luadeprataart/LED-to-LED-Communication/Documentacao/Validando_COMUNICACAO.jpeg

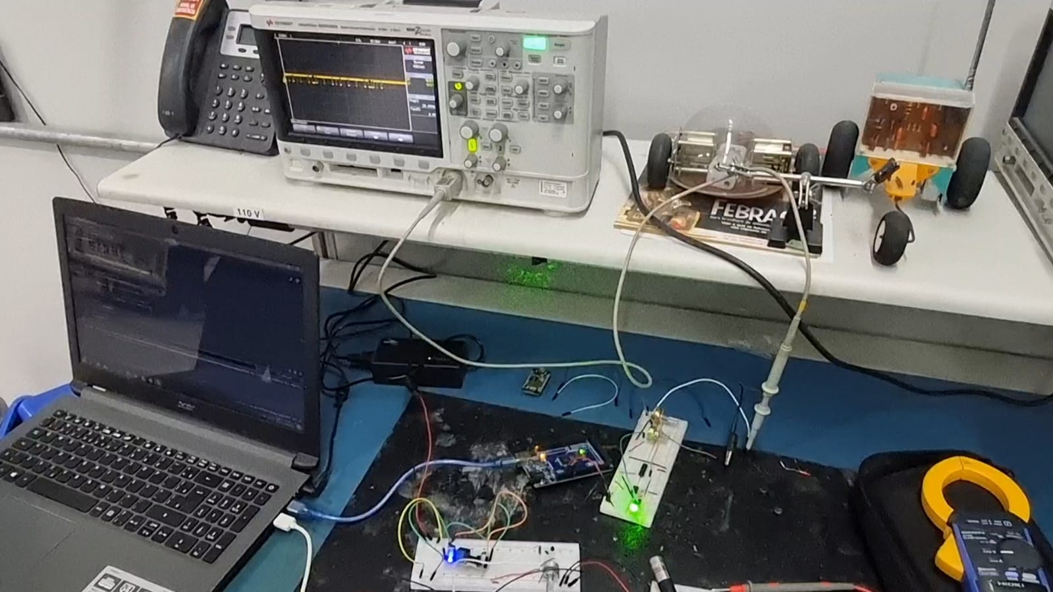
Documentacao/Validando_COMUNICACAO.jpeg
