luadeprataart/LED-to-LED-Communication/Documentacao/Validando_COMUNICACAO2.jpeg

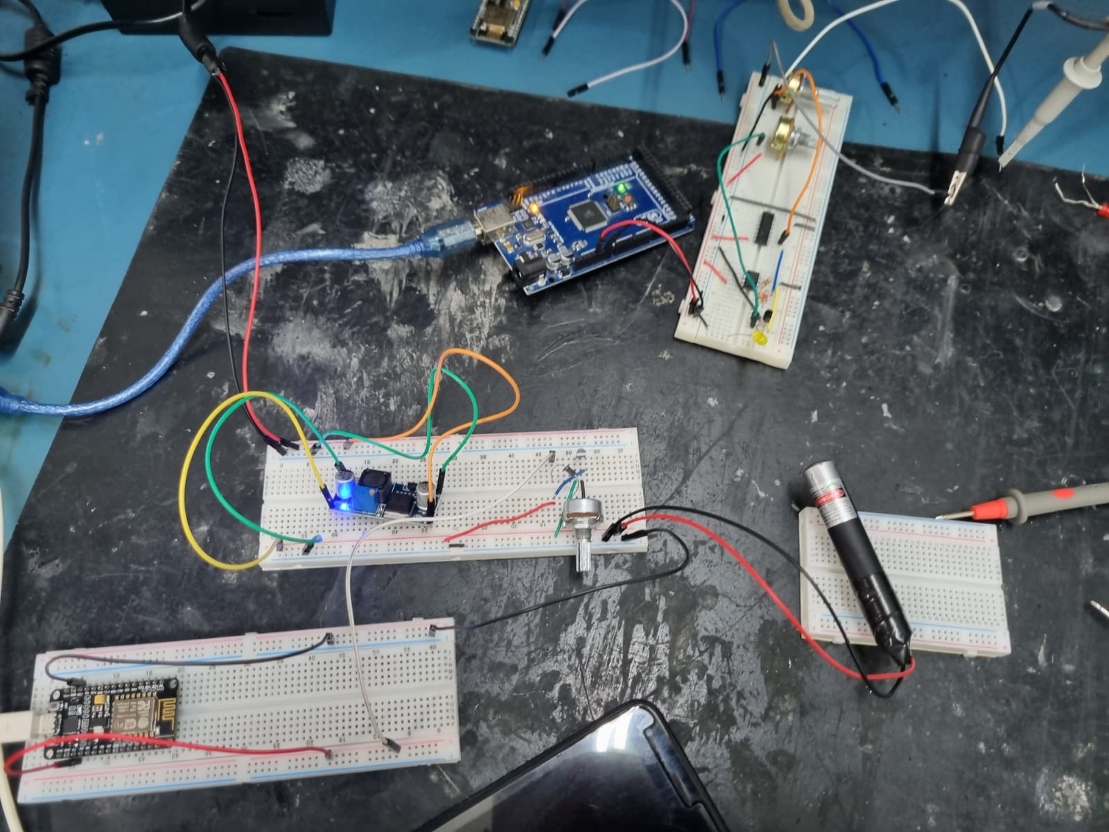
Documentacao/Validando_COMUNICACAO2.jpeg
