luadeprataart/LED-to-LED-Communication/README.md

# LED-to-LED-Communication
Transferência de dados utilizando o método LI-FI aplicado a um LED de 5mm atuando como Receptor da comunicação e um laser como Transmissor.
Este trabalho apresenta uma pesquisa sobre a viabilidade da transmissão de dados por luz entre
dois LEDs comuns. O objetivo principal é validar a utilização de LEDs comuns como uma solução acessível para a
tecnologia Li-Fi (Light Fidelity). 

## Componentes utilizados 

### Receptor 
* Esp8266 nodemcu
* LED 5mm amarelo
* 2N7000 mosfet
* LM358 amplificador operacional
* 74HC14 schmitt trigger
* Resistor 120Ω
* Resistor 1KΩ
* Resistor 220Ω
* Resistor 10kΩ
* Potenciômetro 10kΩ

### Emissor 
* Esp8266 nodemcu 
* Laser verde de 5mW 
* Potenciômetro 100kΩ
* Transistor PNP BC558B
* Módulo regulador de tensão Stepdown LM2596
* Díodo 1N4001
