luadeprataart/LED-to-LED-Communication/Documentacao/LASER.jpeg

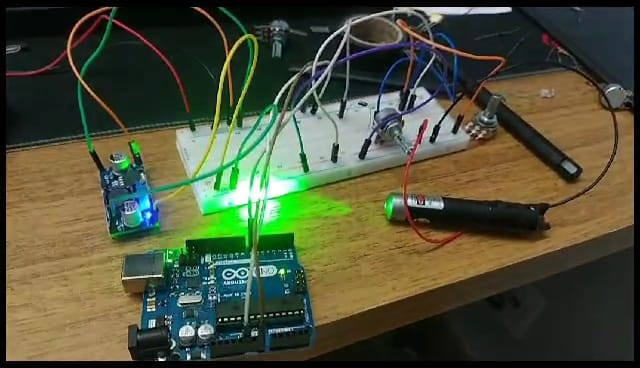
Documentacao/LASER.jpeg
