luadeprataart/LED-to-LED-Communication/Emissor/Circuito/esquematico.jpeg

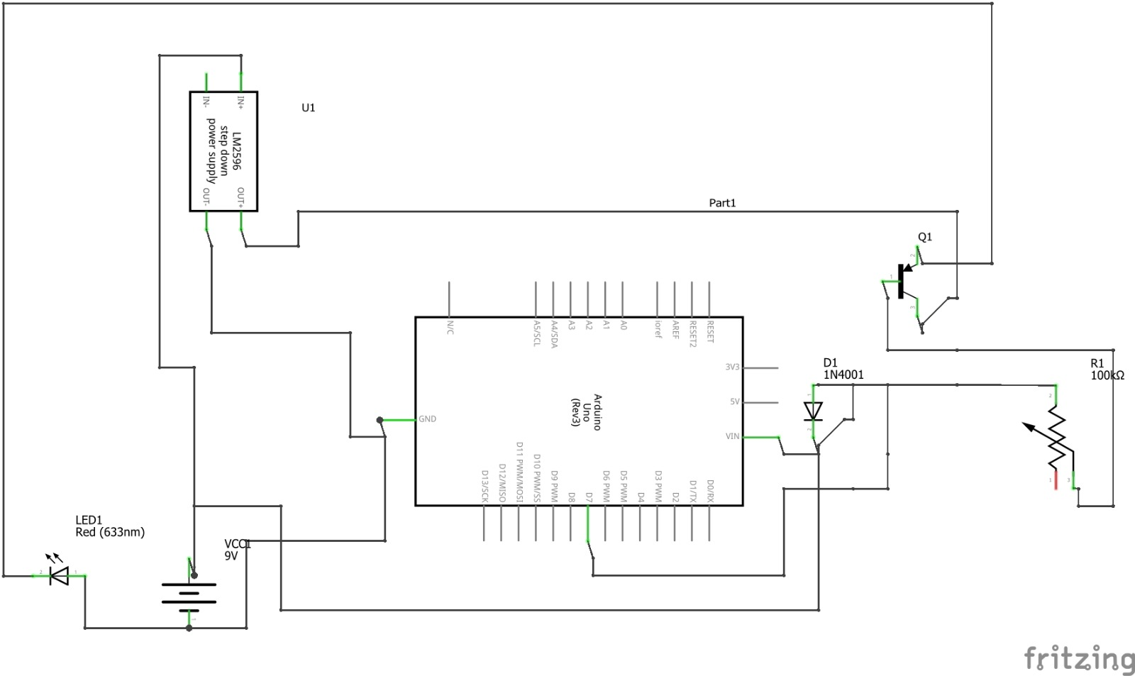
Emissor/Circuito/esquematico.jpeg
