luadeprataart/LED-to-LED-Communication/Receptor/Circuito/diagrama.jpeg

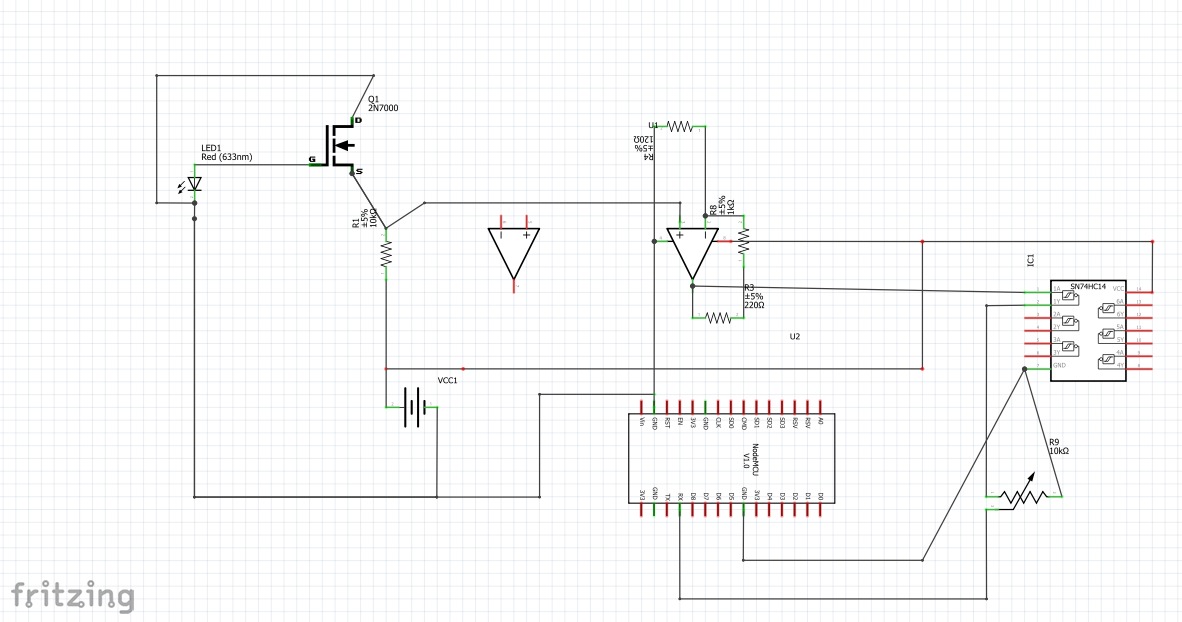
Receptor/Circuito/diagrama.jpeg
