luadeprataart/LED-to-LED-Communication/Receptor/Circuito/protoboard.jpeg

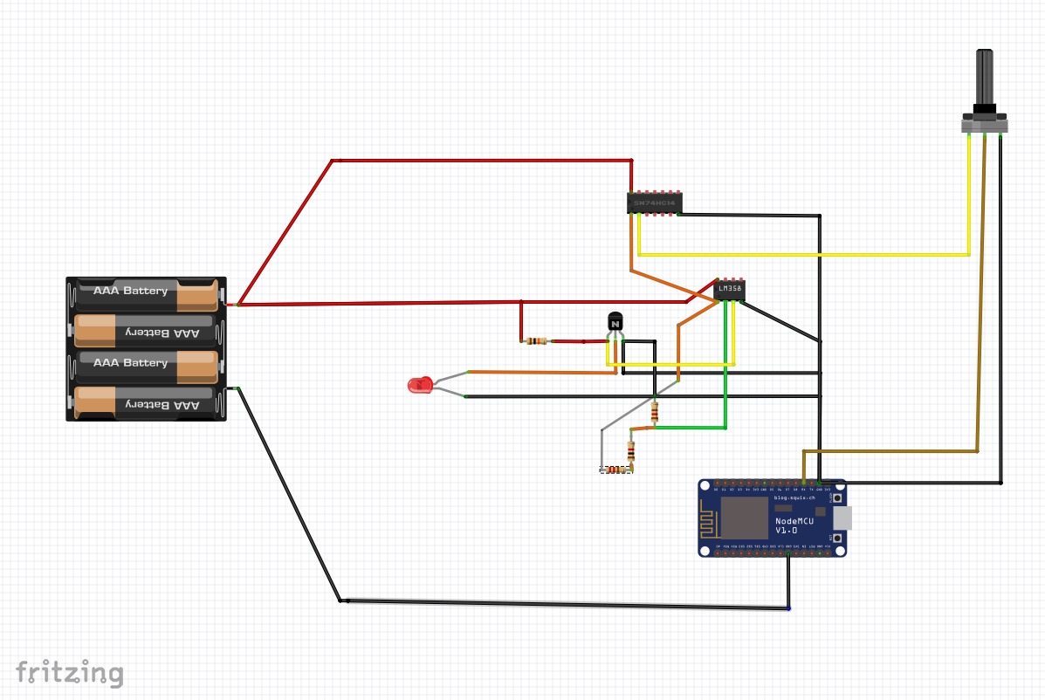
Receptor/Circuito/protoboard.jpeg
